Chansnow/lunShiGeDou/README.md

# 轮式格斗机器人

采用的主控为内核为STM32的控制器模块，其他传感器包括红外对管、超声波测距模块等。要求制作的车模在登上擂台后将对方车辆推下擂台。

## 设计框架
本车利用主控提供的16个AD通道，与数字量红外传感器和模拟量红外测距相连，进行敌方车辆测距、台上边缘检测、台下识别。通过输入pwm波对电机进行转速控制，达到直行、转弯等效果。
调试时在自带LCD屏幕上显示红外数值。

### 系统框架设计：
lunShi1

### solidworks建模图：
lunShi2

### 车模成品：
lunShi3

### 程序控制流程：
lunShi4
lunShi5
lunShi6
