Chansnow/lunShiGeDou/轮式二队报告.pdf

1 / 19

# 浙江省第二届大学生智能机器人创 意大赛（主题三轮式自主格斗）

# 作品设计说明

2 / 19

目录

3 / 19

第一章 引言

大赛简介：

智能机器人格斗大赛（Intelligent Robot Fighting Competition，简称IRFC）， IRFC将中国武术、竞技运动与人工智能、机器人等技术结合，融技术性、对 抗性、挑战性、观赏性于一体，参赛队伍进行一对一、多对多等不同项目的 角逐。
为进一步推进学生创新意识和创造能力培养，强化学生动手能力和工程实践 能力，激励广大学生踊跃参加课外科技活动，有效推动新工科人才培养，促 进校际交流。经浙江省大学生智能机器人创意竞赛组委会研究，决定举行浙 江省第二届大学生智能机器人创意竞赛

其他：
准备比赛过程中收获到的成果离不开学校的大力支持以及老师的悉心教导， 在此对学校以及老师表示衷心的感谢。

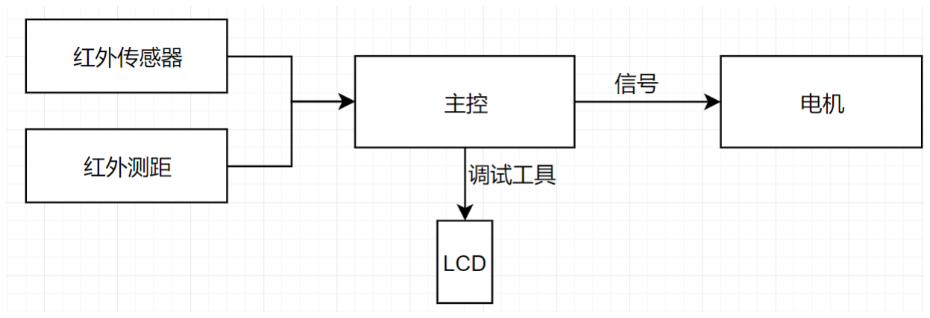
[picture p1: figure]
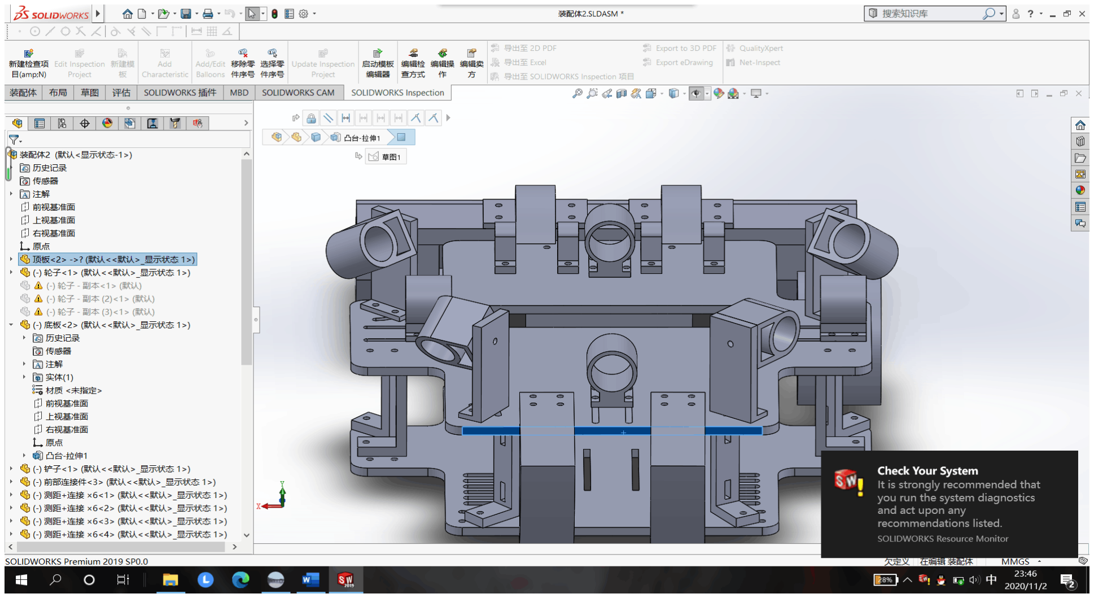
[picture p2: figure]

4 / 19

第二章 整体设计

### 2.1 设计框架概述：

本车利用主控提供的 16 个 AD 通道，与数字量红外传感器和模拟量红外测距

相连，进行敌方车辆测距、台上边缘检测、台下识别。通过输入 pwm 波对电机进

行转速控制，达到直行、转弯等效果。

调试时在自带 LCD 屏幕上显示红外数值。

以下为系统框架设计：

图 2.1 设计框架

### 2.2 车模整体布局

车模采用了 16 个传感器，八个红外传感器以及八个测距传感器。其中四个

红外传感器用作边缘检测，让车在靠近台子边缘事能够及时停下，另外四个红外

传感器在台上时检测敌方车辆，在台下时能够确定自身位置并进行调整。测距传

感器在台上时检测敌方车辆，在台下能够确认自身状态早起台下，具体分布如图：

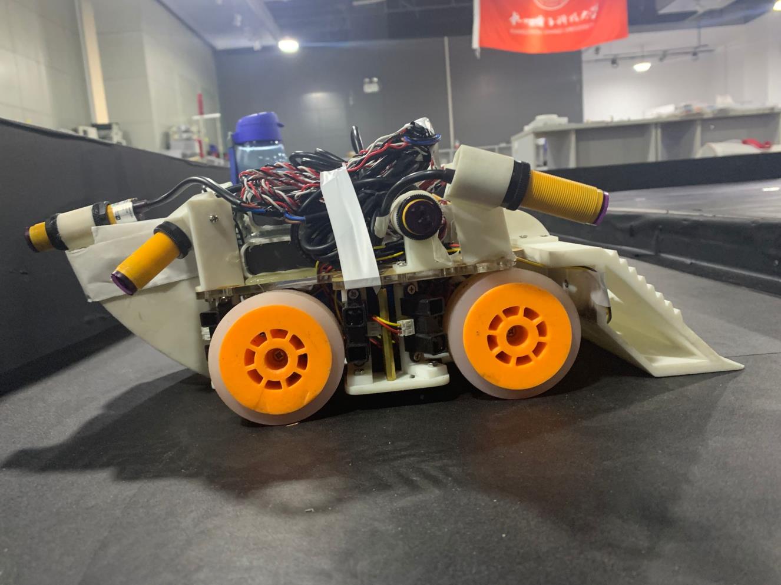
[picture p3: figure]

5 / 19

图 2.2 车模整体布局

### 2.3 主要模块介绍

车身模块主要分为：边缘检测模块；

台上台下检测模块；

寻敌攻击模块；

供电模块；

车身机械结构模块。

附实物图

图 2.3 成品车模

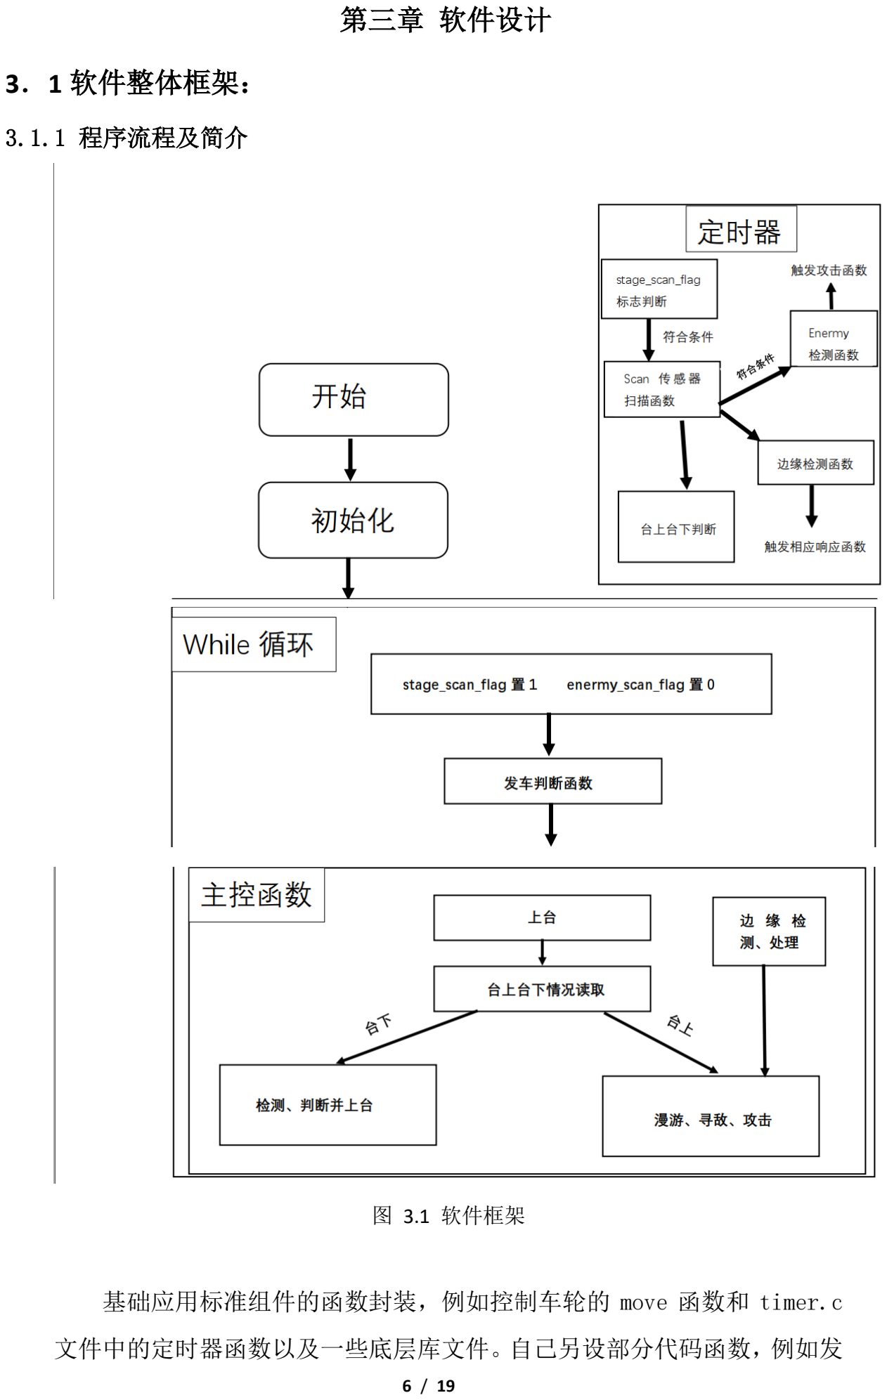
[picture p4: page 6]

6 / 19

第三章 软件设计

3．1 软件整体框架：

3.1.1 程序流程及简介

图 3.1 软件框架

基础应用标准组件的函数封装，例如控制车轮的 move 函数和 timer.c

文件中的定时器函数以及一些底层库文件。自己另设部分代码函数，例如发

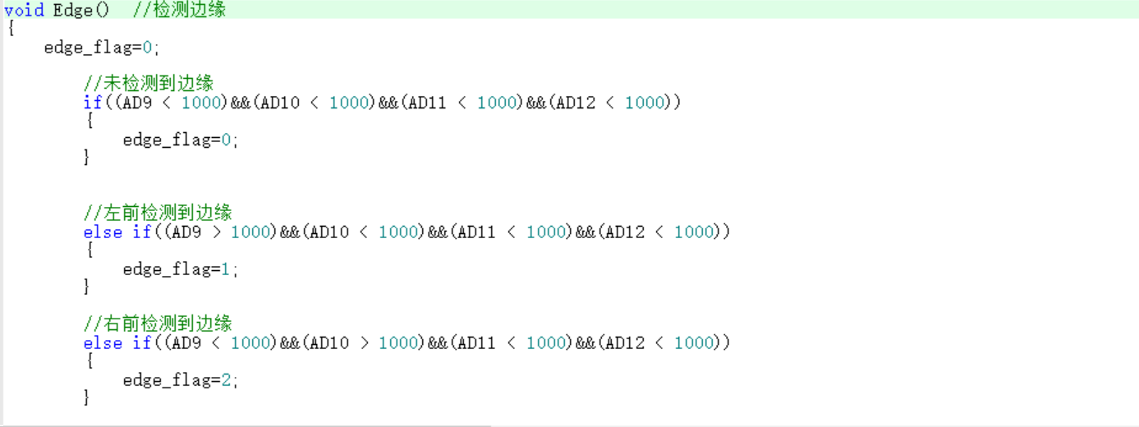
[picture p5: figure]
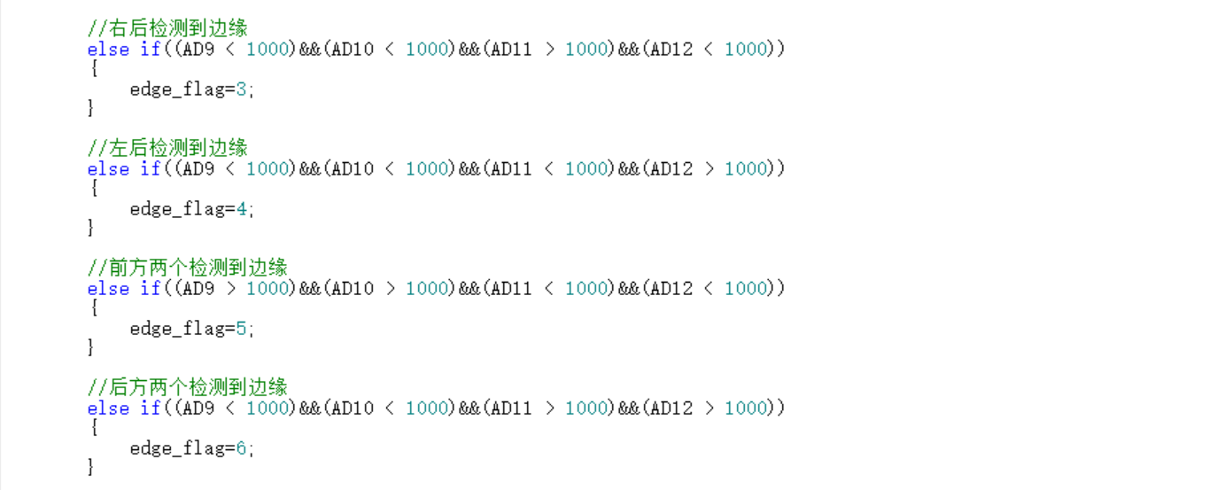
[picture p6: figure]

7 / 19

车、边缘检测、寻觅敌方车辆、攻击、位置检测等函数。对整体框架做了一

定的修改，将各个检测函数放入定时器内对车模进行实时监测，返回相应返

回值用来触发检测或进入状态处理函数，对于每一个情况做出相应的判断和

相应的行动。

3.1.2 软件改进：

将原有的 delay 算法改为实时监测的算法。运用函数返回值在定时器中

控制各检测函数的触发与否。新增加刹车优化算法等等，使得车辆进一步的

稳定。另外添加多种情况，添加卡尔曼滤波算法，加强稳定鲁棒性。

### 3.2 边缘检测算法：

我们采用在车的四角各安放一个红外光电传感器的策略，将传感器倾斜朝下

检测，适当调整倾角及检测距离，使之能正确识别边缘。

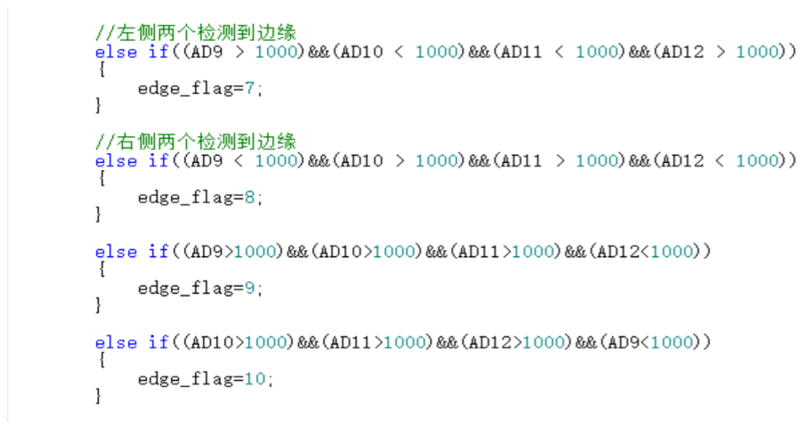
[picture p7: figure]
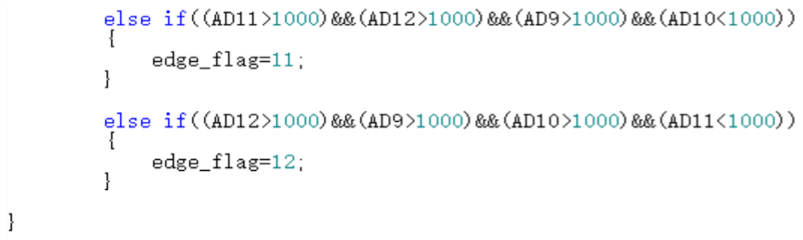
[picture p8: figure]
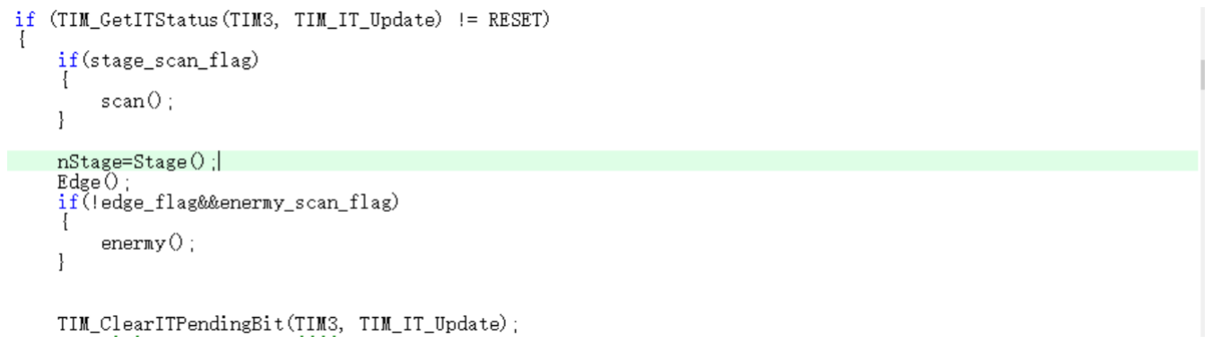
[picture p9: figure]

8 / 19

图 3.2 边缘检测函数设计
设计思路：通过各种 if 语句，根据四角红外传感器的返回值，给出相应判断，

判断车处于边缘的什么位置，车的哪个部位对着边缘，返回对应的 edge_flag 值，

有主控函数来接受 edge_flag 的值做出相应判断控制车模的运动。

### 3.3 定时器核心算法：

我们采用将各检测函数放入定时器实时检测的方法，实时检测车模的状态，

和触发相应的控制函数。

图 3.3 定时器算法设计
Scan 函数作用：扫描，用来获取车上 16 个传感器的 AD 值。

Stage_scan_flag 作用：在扫描函数前加以判断，发车时开启扫描函数，上台时关

闭扫描函数，防止其传入的值触发台上台下检测函数或边缘检测函数对上台造成

干扰。

Stage 函数：通过返回值表明车模是在台上还是台下。

Edge：边缘检测函数。

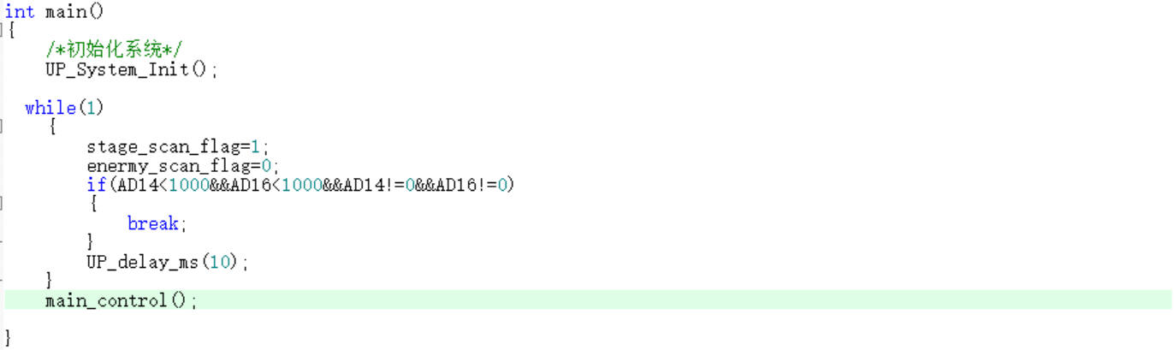
[picture p10: figure]
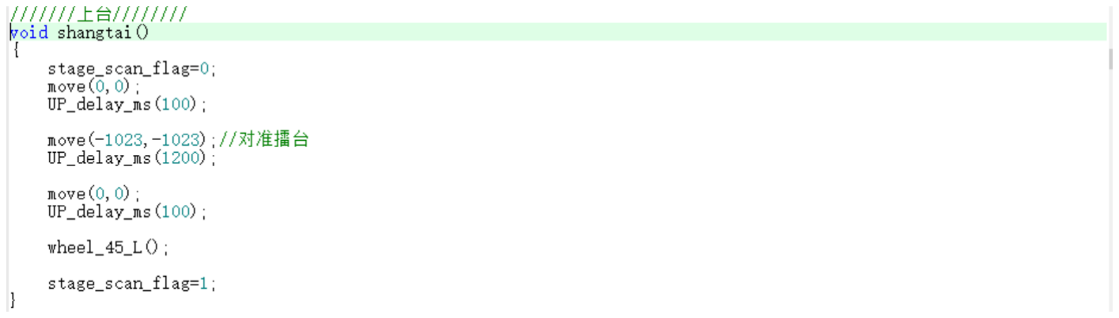
[picture p11: figure]

9 / 19

Edge_flag 及 enermy_scan_flag：给寻敌函数加一限制，使车模在台上且没有到达

边缘（即漫游）时才进行寻敌，防止发生误判。

### 3.4 主函数 main()

图 3.4 主函数设计
功能：发车检测

发车时 stage_scan_flag 置 1，开启 scan 扫描函数，使得发车检测能够进行。

### 3.5 主控函数 main_control()

3.5.1 上台函数

图 3.5.1 上台函数设计
stage_scan_flag 置 0，关闭 scan 扫描函数，先使车停下，防止上一状态是转

弯影响上台。对准擂台后，四轮倒转速度拉满，猛冲 1200ms 后停下，使车模得

以稳定。最后车模左转 45°，stage_scan_flag 置 1，开启 scan 扫描函数，使车在

台上顺利进行漫游、寻敌、边缘检测等操作。

3.5.2 漫游函数

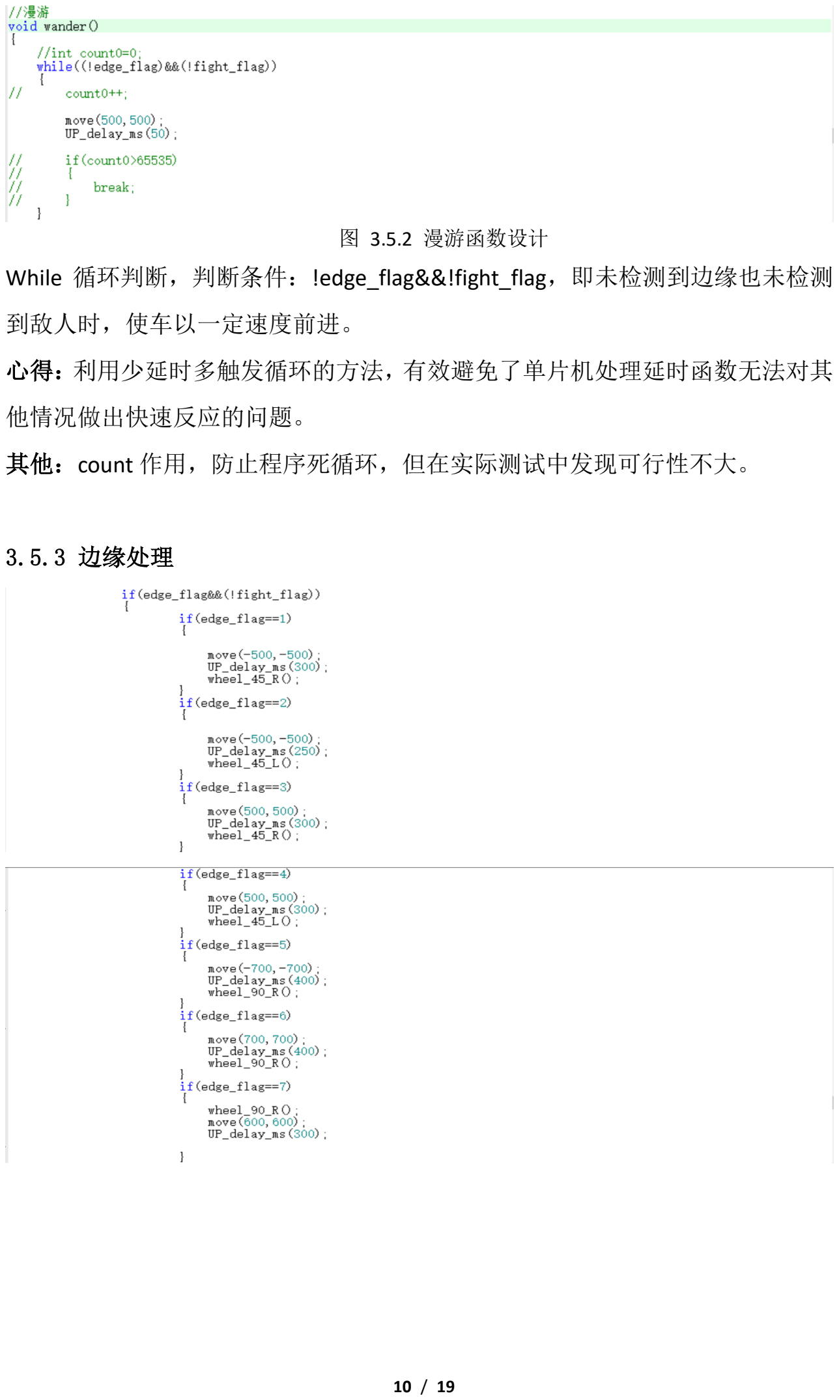
[picture p12: page 10]

10 / 19

图 3.5.2 漫游函数设计
While 循环判断，判断条件：!edge_flag&&!fight_flag，即未检测到边缘也未检测

到敌人时，使车以一定速度前进。

心得：利用少延时多触发循环的方法，有效避免了单片机处理延时函数无法对其

他情况做出快速反应的问题。

其他：count 作用，防止程序死循环，但在实际测试中发现可行性不大。

3.5.3 边缘处理

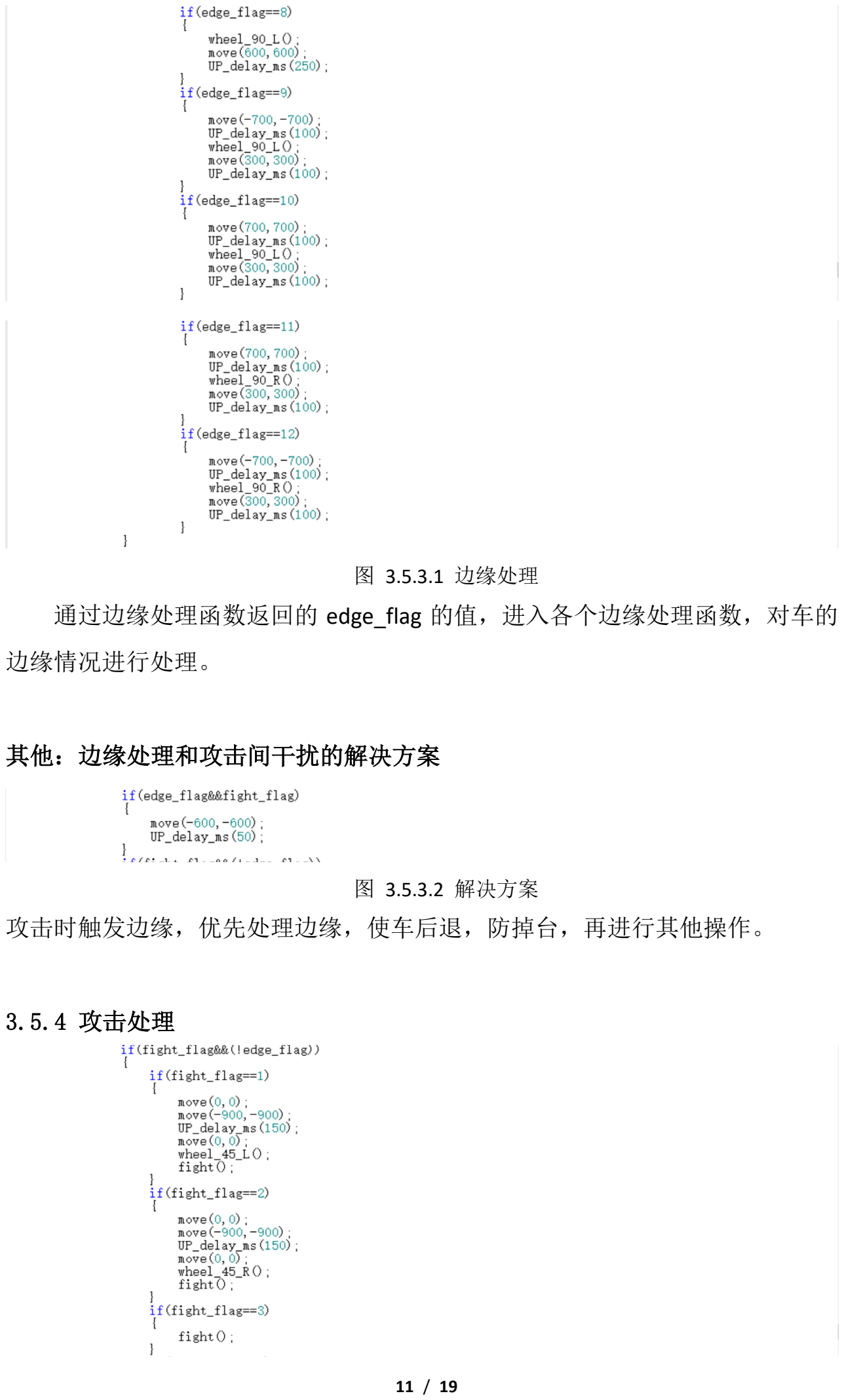
[picture p13: page 11]

11 / 19

图 3.5.3.1 边缘处理
通过边缘处理函数返回的 edge_flag 的值，进入各个边缘处理函数，对车的

边缘情况进行处理。

其他：边缘处理和攻击间干扰的解决方案

图 3.5.3.2 解决方案
攻击时触发边缘，优先处理边缘，使车后退，防掉台，再进行其他操作。

3.5.4 攻击处理

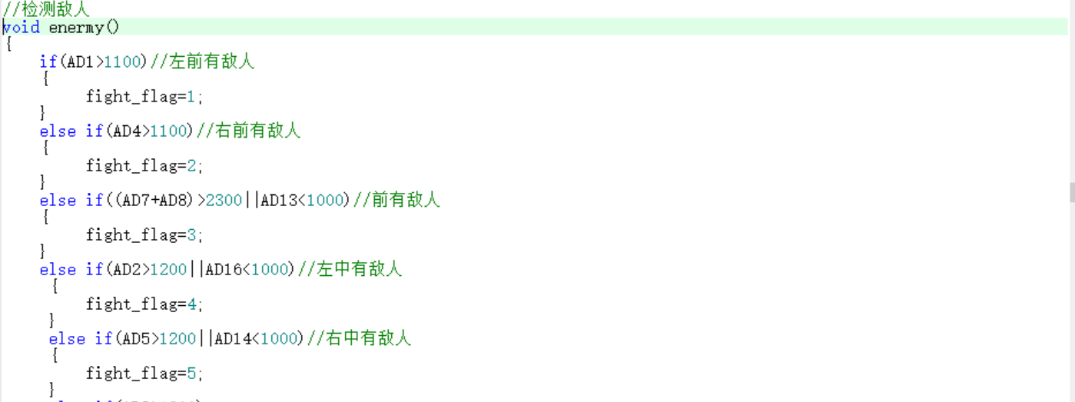
[picture p14: figure]
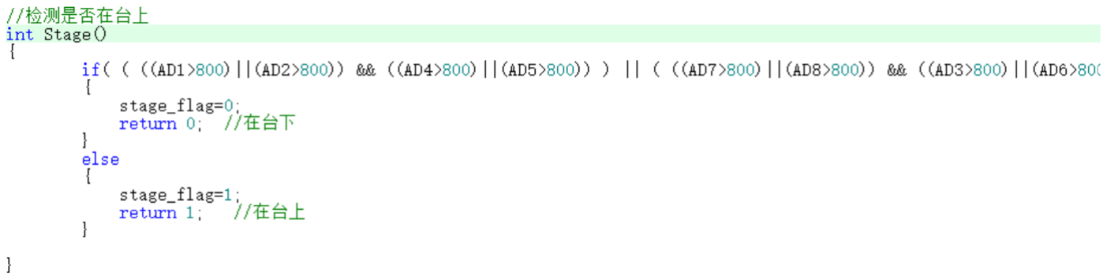
[picture p15: figure]

12 / 19

图 3.5.4 攻击函数
通过寻敌扫描返回的 fight_flag 值，进入各个情况，触发相应函数，对前、

后、左、右、左前、右前等方向出现的敌人进行各种不同的反应。

3.5.5 寻敌函数

图 3.5.5 寻敌函数
通过前后左右红外光电传感器，左前左中右前右中测距传感器传入的 AD 值，

对四周敌人的方位进行有效的判断，返回相应的 fight_flag 值，在攻击函数中触

发相应操作。

3.5.6 台上台下检测

图 3.5.6 台上台下检测函数
通过车四周靠下的测距传感器判断是否在台下，若右两侧同时检测到较近物

体，则说明车在台下，反之则车在台上。并返回相应判断标志值。

3.5.7 软件算法改进

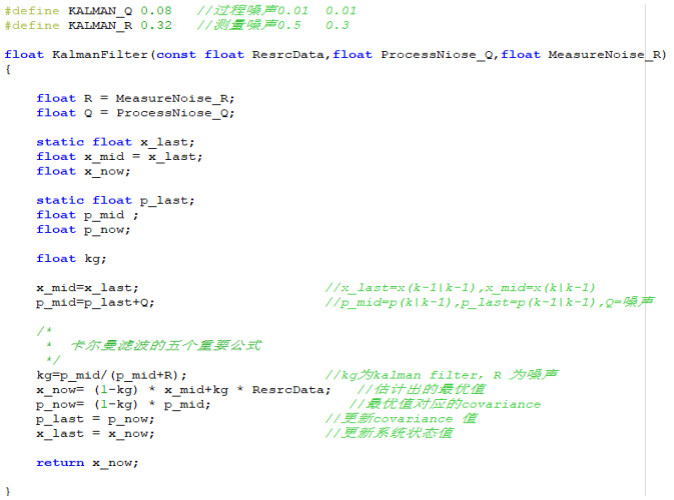
[picture p16: figure]

13 / 19

图 3.5.7.1 传感器数值图
实测发现，车模上安装的测距传感器数值在较近距离检测到物体时会急剧减

小，在离传感器 15cm 左右得到的 AD 值最大，给我们的调试带来了很大的困难，

多次实验，最后选用卡尔曼滤波算法，有效降低了噪声值，增加了平滑度。

图 3.5.7.2 卡尔曼滤波算法

1115

1252

1452

1712

2140
1968
1792

1547

1268 1268

0

500

1000

1500

2000

2500

5 | 7 | 9 | 10 | 15 | 20 | 25 | 30 | 40 | 50

传感器AD值

传感器AD值

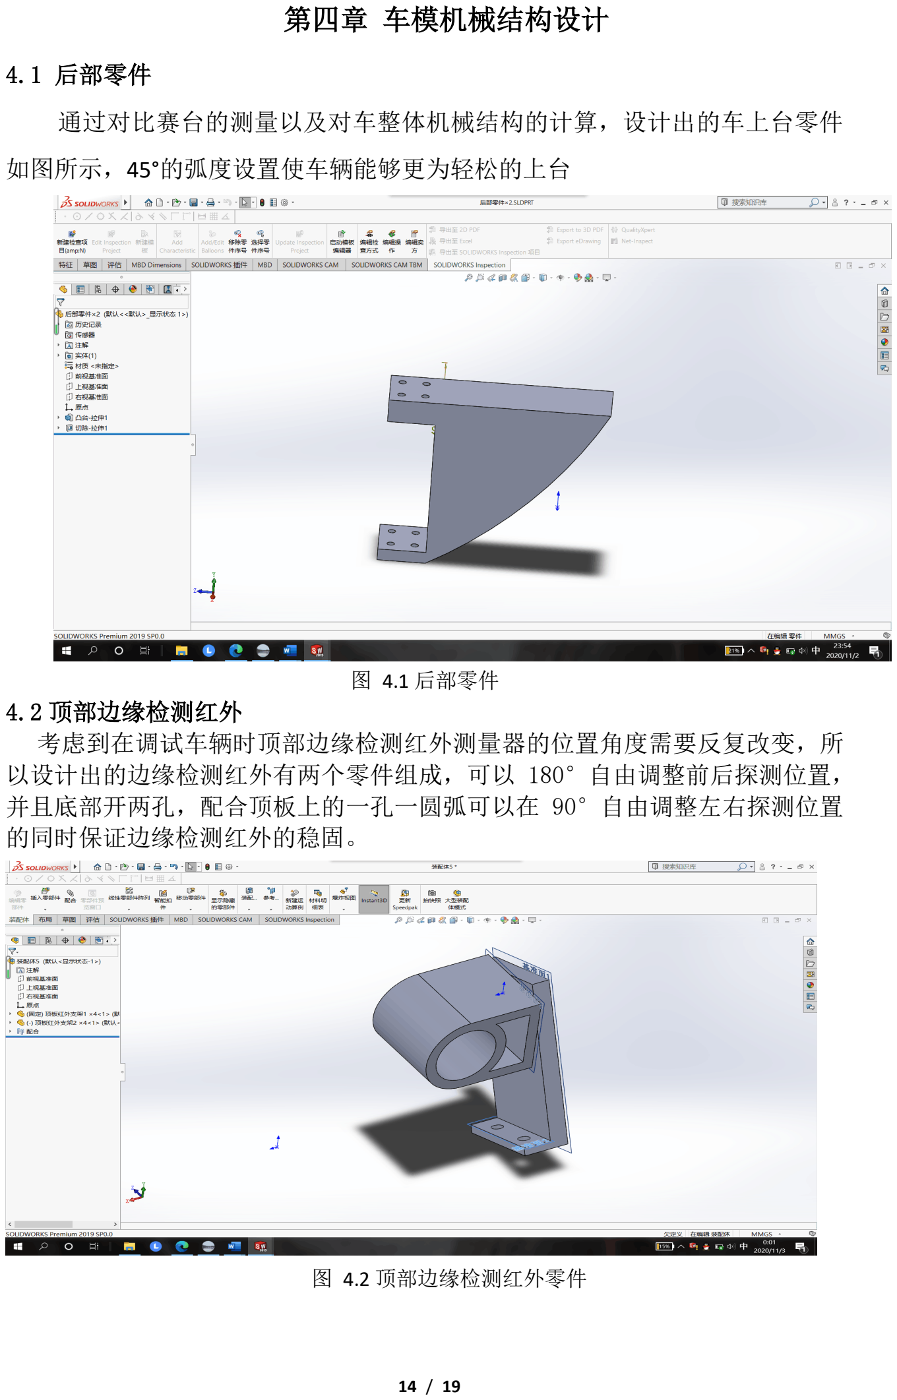
[picture p17: page 14]

14 / 19

第四章 车模机械结构设计

4.1 后部零件

通过对比赛台的测量以及对车整体机械结构的计算，设计出的车上台零件

如图所示，45°的弧度设置使车辆能够更为轻松的上台

图 4.1 后部零件
4.2 顶部边缘检测红外
考虑到在调试车辆时顶部边缘检测红外测量器的位置角度需要反复改变，所 以设计出的边缘检测红外有两个零件组成，可以 180°自由调整前后探测位置， 并且底部开两孔，配合顶板上的一孔一圆弧可以在 90°自由调整左右探测位置 的同时保证边缘检测红外的稳固。

图 4.2 顶部边缘检测红外零件

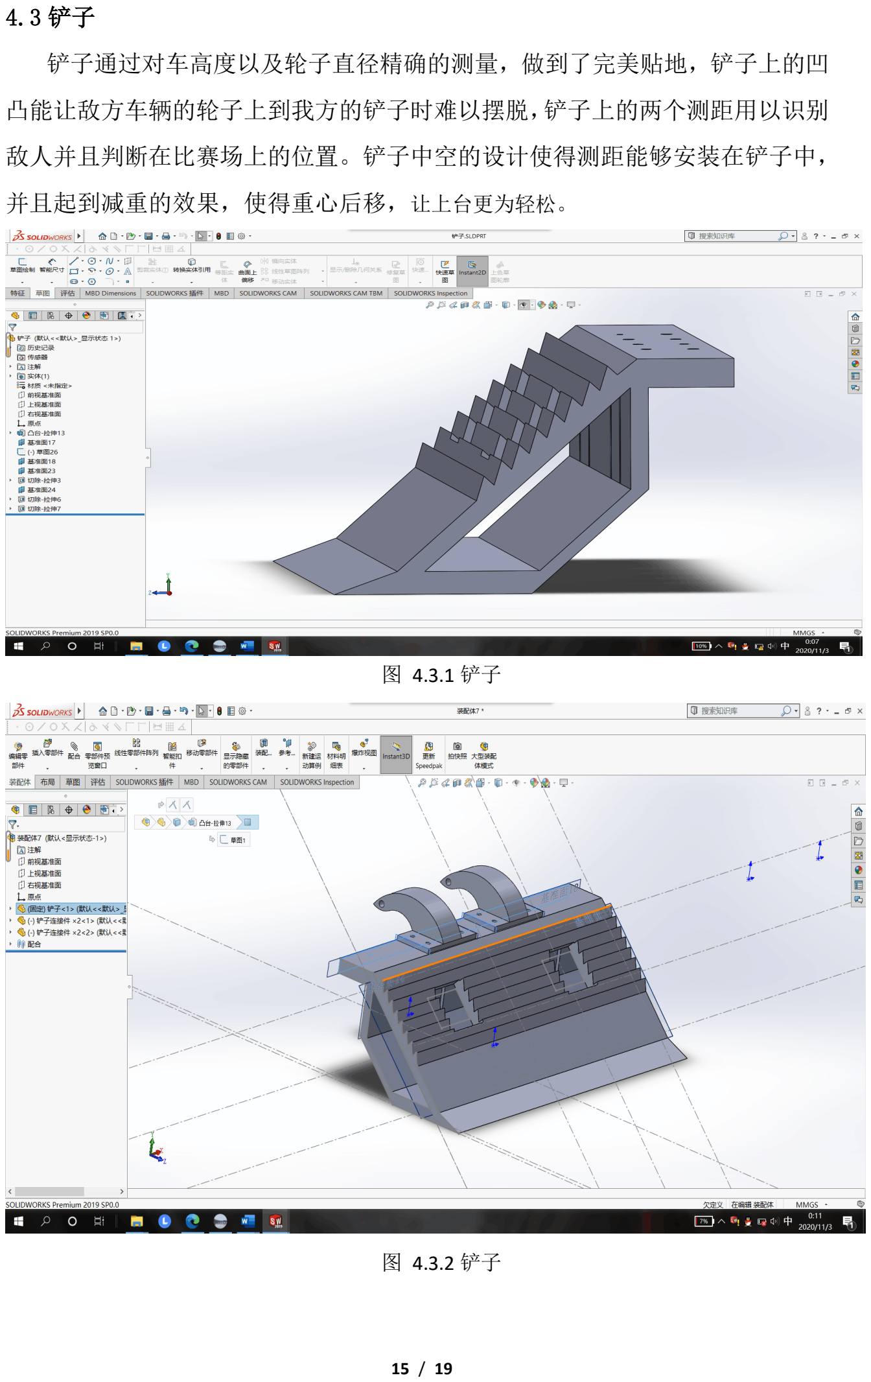
[picture p18: page 15]

15 / 19

4.3 铲子

铲子通过对车高度以及轮子直径精确的测量，做到了完美贴地，铲子上的凹

凸能让敌方车辆的轮子上到我方的铲子时难以摆脱，铲子上的两个测距用以识别

敌人并且判断在比赛场上的位置。铲子中空的设计使得测距能够安装在铲子中，

并且起到减重的效果，使得重心后移，让上台更为轻松。

图 4.3.1 铲子

图 4.3.2 铲子

16 / 19

第五章 问题及解决方案

### 1 车无法上坡问题

问题原因 1：车在上坡过程中卡在台阶上，经多次尝试发现卡住过程中车前轮，

即在台下的轮子离地悬空，后轮也处于半空中，所以轮子无法给予车动力，由

此车卡住了。

解决方案：将前轮前移，使后轮悬空时，前轮仍着地，给予车动力，问题解决。

问题原因 2：车在上车过程中车冲的时间远远短于程序设计时间，冲到一半就

断电。

解决方案：反复实验发现传感器的线离电池开关太近，上台时车身倾斜导致传

感器的线碰到开关使得开关断开。将传感器的线固定在离开关较远位置，问题

解决。

问题原因 3：车上台过程中猛冲后仍掉下台翻车。

解决方案：实验发现车身重心靠前，导致车上台后车尾不够重，重心不在台上

导致上不了台。将车重心后移，车尾增重，问题解决。

### 2 进入攻击状态时边缘检测失效

问题原因：发现在执行延时函数时，无法从中断中读取红外值。而攻击函数大

部分时间都在实现延时，所以在攻击时边缘检测失效

解决方案：减小攻击延时，反复检测，少延时多执行，反复进入判断函数。并

在攻击函数中手动添加红外扫描与检测边缘后退程序。

### 3 车到达擂台拐角边缘出现打转现象导致下台

问题原因：边缘处理函数中，转弯延时过长，导致拐弯过大，使其他边缘检测

红外传感器检测到边缘，触发另外的边缘处理函数，反复打转。

解决方案：在软件中减少转弯延时，将边缘检测处理函数化繁为简，并适当改

变边缘检测函数倾角，反复实验，问题解决。

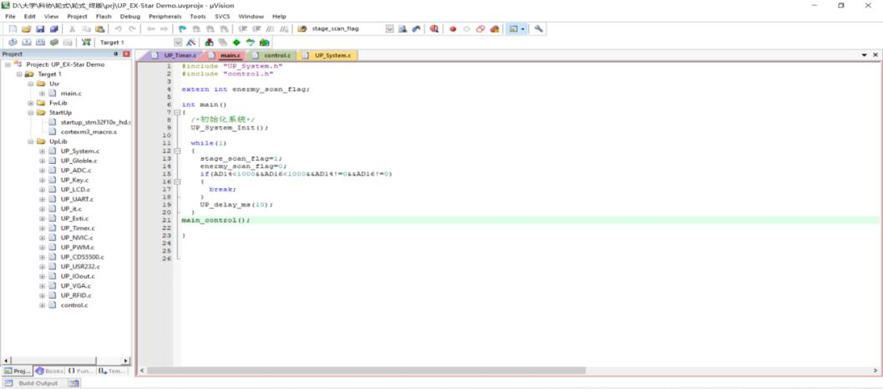
[picture p19: figure]
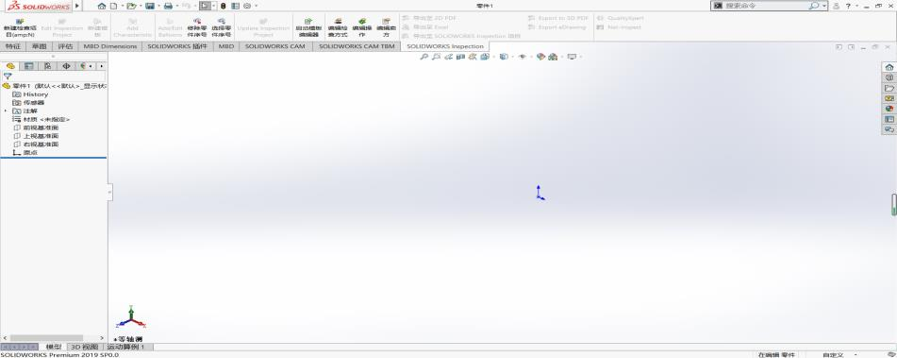
[picture p20: figure]

17 / 19

第六章 开发及调试工具

### 6.1 Keil

Keil MDK-ARM 是美国 Keil 软件公司（现已被 ARM 公司收购）出品的支持 ARM

微控制器的一款 IDE（集成开发环境）。MDK-ARM 包含了工业标准的 Keil C 编译

器、宏汇编器、调试器、实时内核等组件。具有 ARM C/C++编译工具链，完美支

持 Cortex-M、Cortex-R4、ARM7 和 ARM9 系列器件，包含世界上品牌的芯片。比

如：ST、Atmel、Freescale、NXP、TI 等众多大公司微控制器芯片。

图 6.1 Keil 界面

### 6.2 SolidWorks

SolidWorks 是达索系统（Dassault Systemes ）下的子公司，专门负责研发与

销售机械设计软件的视窗产品，公司总部位于美国马萨诸塞州。达索公司是负责

系统性的软件供应，并为制造厂商提供具有 Internet 整合能力的支援服务。该集

团提供涵盖整个产品生命周期的系统，包括设计、工程、制造和产品数据管理等

各个领域中的最佳软件系统，著名的 CATIAV5 就出自该公司之手，目前达索的

CAD 产品市场占有率居世界前列

图 6.2SolidWorks 界面

18 / 19

第七章 主要参数说明

项目 | 参数
车功能用途描述 | 该车经调试，能够满足定位敌车（障碍 物），边缘检测等功能。
车几何尺寸(长 X 宽 X 高)/cm | 27.5*27.5
车模重量(带有电池) | 3.38kg
传感器种类及个数 | 红外传感器 8 个 红外测距 8 个
电机个数 | 4
赛道信息检测频率 | 72HZ

19 / 19

第八章 总结

从组队参加轮式比赛，到软件代码构建与硬件车模构建和组装，再到调试轮

式车与准备比赛，其中遇到过许许多多濒临崩溃或令人骄傲的瞬间，报告之中，

区区百字，难以一言蔽之。但是，我们仍然希望这份承载着我们初心与努力的报

告，能给予他人启发与帮助。

我们在调车过程中，发现了测距的不稳定性，大约 15cm 以内的测距属于失

效状态，并不会随着距离增加而减小数值，这给调车带来了很大的难度。于是我

们采用了卡尔曼滤波算法增加平滑度，再用红外传感与测距配合的方法，近距离

测量尽量使用红外，尽最大努力减速测距的影响。我们相信轮式的车模构造和代

码编写还有许许多多改善之处，也希望能给予我们宝贵的改正意见。士不可以不

弘毅，任重而道远。几个月的竞赛经历，让我们明白了远大理想和坚持不懈的重

要性，未来的路还很长，竞赛经历将成为我们人生中宝贵的财富。
