Chansnow/lunShiGeDou/src/UpLib/UP_MP3.h

#ifndef UP_MP3_H
#define UP_MP3_H


extern void UP_MP3_Init(void);
extern void UP_MP3_PlaySound(u8 num);
extern void UP_MP3_SetVolume(u8 volume);
extern void UP_MP3_Pause(void);















#endif 
