Chansnow/lunShiGeDou/(notices)

Notices in the files:
src/UpLib/UP_PWM.h:
Copyright (C), 2011-2012, ±±¾©²©´´
src/UpLib/UP_Bluetooth.c:
Copyright (C), 2011-2013, ±±¾©²©´´
